charbel-j-estephan/CAN_IDS_IPS/esp32/replay_sender/replay_sender.ino

/* Sender: replays dataset frames onto the CAN bus with their original timing.
 *
 * The PC (python/replay_dataset.py) streams frames over USB serial, each with
 * the time it had in the original capture. This board waits until that moment
 * and then sends the frame, so the bus carries the same traffic pattern the
 * car did. Use a data cable: the PC needs this board's COM port.
 *
 * In the 3-board bench this board sends the normal traffic, and its first frame
 * is the start marker the attacker (attack_sender) starts its clock on.
 *
 * Serial protocol, 921600 baud, 8N1:
 *   board -> PC   "READY\n" once at boot
 *   PC -> board   15 byte packets: id_hi id_lo dlc d0..d7 t0 t1 t2 t3
 *                 t is a 32 bit little endian count of microseconds since the
 *                 first frame. t = 0 means "send now" (used for the fast mode).
 *   board -> PC   one byte 'A' after every ACK_EVERY frames sent
 *   PC -> board   'Q'  ->  "#TX sent=<n> late=<n> maxlate=<us> tec=<n> rec=<n>
 *                           state=<running|busoff|recovering|stopped>
 *                           arblost=<n> txfail=<n> buserr=<n>\n"
 *
 * "late" counts frames handed to the CAN controller more than 100 us after
 * their time. tec/rec are the controller's transmit/receive error counters,
 * arblost how often another node won arbitration (for example a DoS attacker
 * with ID 0x000), txfail frames that could not be sent.
 *
 * Wiring: module TX -> GPIO 5, module RX -> GPIO 4. See docs/ESP32_WIRING.md
 */
#include "driver/twai.h"
#include "esp_timer.h"

#define PIN_CAN_TX  GPIO_NUM_5
#define PIN_CAN_RX  GPIO_NUM_4
#define ACK_EVERY   64
#define PACKET_LEN  15

// Start marker for the attacker (same as attack_sender.ino): ID 0x7FF with
// "CANSTART", 224 us on the wire. When the first packet is the marker, time
// zero is taken from when the marker finished going out, minus its length:
// exactly how the attacker sets its time zero when it hears the marker. Taking
// it when the frame is handed to the controller instead made the attacker run
// about 77 us late.
#define MARKER_ID   0x7FF
#define MARKER_US   224
static const uint8_t MARKER_DATA[8] = {'C', 'A', 'N', 'S', 'T', 'A', 'R', 'T'};

// Final report. Lower case words only: the PC strips the 'A' ack bytes.
static void report(uint32_t sent, uint32_t late, uint32_t max_late)
{
    twai_status_info_t s = {};
    twai_get_status_info(&s);
    const char *state = s.state == TWAI_STATE_RUNNING ? "running"
                      : s.state == TWAI_STATE_BUS_OFF ? "busoff"
                      : s.state == TWAI_STATE_RECOVERING ? "recovering" : "stopped";
    Serial.printf("#TX sent=%lu late=%lu maxlate=%lu tec=%lu rec=%lu state=%s arblost=%lu txfail=%lu buserr=%lu\n",
                  (unsigned long)sent, (unsigned long)late, (unsigned long)max_late,
                  (unsigned long)s.tx_error_counter, (unsigned long)s.rx_error_counter, state,
                  (unsigned long)s.arb_lost_count, (unsigned long)s.tx_failed_count,
                  (unsigned long)s.bus_error_count);
}

void setup()
{
    Serial.setRxBufferSize(8192);
    Serial.begin(921600);

    twai_general_config_t g = TWAI_GENERAL_CONFIG_DEFAULT(PIN_CAN_TX, PIN_CAN_RX, TWAI_MODE_NORMAL);
    g.tx_queue_len = 16;
    g.alerts_enabled = TWAI_ALERT_TX_SUCCESS;    // to time the start marker
    twai_timing_config_t t = TWAI_TIMING_CONFIG_500KBITS();
    twai_filter_config_t f = TWAI_FILTER_CONFIG_ACCEPT_ALL();

    while (twai_driver_install(&g, &t, &f) != ESP_OK || twai_start() != ESP_OK) {
        Serial.println("CAN init failed. Retrying");
        twai_driver_uninstall();
        delay(500);
    }
    Serial.println("READY");
}

void loop()
{
    static uint8_t pkt[PACKET_LEN];
    static uint32_t sent = 0, late = 0, max_late = 0;
    static int64_t t0 = -1;

    if (Serial.peek() == 'Q' && Serial.available() < PACKET_LEN) {
        Serial.read();
        report(sent, late, max_late);
        return;
    }
    if (Serial.available() < PACKET_LEN)
        return;
    Serial.readBytes(pkt, PACKET_LEN);

    uint32_t rel = (uint32_t)pkt[11] | ((uint32_t)pkt[12] << 8) |
                   ((uint32_t)pkt[13] << 16) | ((uint32_t)pkt[14] << 24);
    uint32_t id = (((uint32_t)pkt[0] << 8) | pkt[1]) & 0x7FF;
    bool marker = t0 < 0 && id == MARKER_ID && pkt[2] == 8 && memcmp(&pkt[3], MARKER_DATA, 8) == 0;
    if (t0 < 0 && !marker)
        t0 = esp_timer_get_time();       // the first frame defines time zero

    if (rel && t0 >= 0) {
        int64_t due = t0 + (int64_t)rel;
        while (esp_timer_get_time() < due) {
        }
        int64_t over = esp_timer_get_time() - due;
        if (over > 100) {
            late++;
            if ((uint32_t)over > max_late)
                max_late = (uint32_t)over;
        }
    }

    twai_message_t m = {};
    m.identifier = (((uint32_t)pkt[0] << 8) | pkt[1]) & 0x7FF;
    m.data_length_code = pkt[2] > 8 ? 8 : pkt[2];
    memcpy(m.data, &pkt[3], m.data_length_code);

    // A timeout means the TX queue was full, the frame was not queued, so
    // retrying cannot duplicate it.
    while (twai_transmit(&m, pdMS_TO_TICKS(100)) == ESP_ERR_TIMEOUT) {
    }

    if (marker) {
        // Poll (no blocking wait) so the moment is caught within microseconds,
        // the same way the attacker polls for the marker it receives.
        uint32_t alerts = 0;
        int64_t give_up = esp_timer_get_time() + 100000;
        while (esp_timer_get_time() < give_up) {
            if (twai_read_alerts(&alerts, 0) == ESP_OK && (alerts & TWAI_ALERT_TX_SUCCESS))
                break;
        }
        t0 = esp_timer_get_time() - MARKER_US;
    }

    if (++sent % ACK_EVERY == 0)
        Serial.write('A');
}
