charbel-j-estephan/CAN_IDS_IPS/mcu/stm32_ids/src/can_ids_model_p8.h

    // !!! This file is generated using emlearn !!!

    #include <stdint.h>

// Where the model's code goes. By default these are ordinary functions. A
// firmware can define CAN_IDS_FN / CAN_IDS_PUBLIC before including this file
// to put them in a linker section, for example RAM (stm32_ids/src/classify.c).
#ifndef CAN_IDS_FN
#define CAN_IDS_FN static inline
#endif
#ifndef CAN_IDS_PUBLIC
#define CAN_IDS_PUBLIC
#endif

    

CAN_IDS_FN int32_t can_ids_tree_0(const float *features, int32_t features_length) {
          if (features[9] < 254.500000f) {
              if (features[0] < 0.500000f) {
                  if (features[7] < 0.500000f) {
                      if (features[5] < 99.500000f) {
                          return 1;
                      } else {
                          return 2;
                      }
                  } else {
                      return 2;
                  }
              } else {
                  if (features[6] < 66.500000f) {
                      if (features[3] < 191.500000f) {
                          if (features[0] < 1520.500000f) {
                              if (features[9] < 20.500000f) {
                                  if (features[6] < 38.500000f) {
                                      if (features[4] < 128.500000f) {
                                          if (features[6] < 18.500000f) {
                                              return 0;
                                          } else {
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
                      }
                  } else {
                      if (features[8] < 55.500000f) {
                          if (features[0] < 330.500000f) {
                              return 0;
                          } else {
                              return 2;
                          }
                      } else {
                          return 2;
                      }
                  }
              }
          }
        }
        

CAN_IDS_PUBLIC int32_t can_ids_predict(const float *features, int32_t features_length) {

        int32_t votes[5] = {0,};
        int32_t _class = -1;

        _class = can_ids_tree_0(features, features_length); votes[_class] += 1;
    _class = can_ids_tree_1(features, features_length); votes[_class] += 1;
    _class = can_ids_tree_2(features, features_length); votes[_class] += 1;
    _class = can_ids_tree_3(features, features_length); votes[_class] += 1;
    _class = can_ids_tree_4(features, features_length); votes[_class] += 1;
    
        int32_t most_voted_class = -1;
        int32_t most_voted_votes = 0;
        for (int32_t i=0; i<5; i++) {

            if (votes[i] > most_voted_votes) {
                most_voted_class = i;
                most_voted_votes = votes[i];
            }
        }
        return most_voted_class;
    }
    

int can_ids_predict_proba(const float *features, int32_t features_length, float *out, int out_length) {

        int32_t _class = -1;

        for (int i=0; i<out_length; i++) {
            out[i] = 0.0f;
        }

        _class = can_ids_tree_0(features, features_length); out[_class] += 1.0f;
    _class = can_ids_tree_1(features, features_length); out[_class] += 1.0f;
    _class = can_ids_tree_2(features, features_length); out[_class] += 1.0f;
    _class = can_ids_tree_3(features, features_length); out[_class] += 1.0f;
    _class = can_ids_tree_4(features, features_length); out[_class] += 1.0f;
    
        // compute mean
        for (int i=0; i<out_length; i++) {
            out[i] = out[i] / 5;
        }
        return 0;
    }
    
// Which model this is: shown by the firmware in READY and #STAT.
#define CAN_IDS_MODEL_ID "rf5-d9-p8-c0f7e8b5"
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
