charbel-j-estephan/CAN_IDS_IPS/(commit log)

2026-09-24 Add training, Verilog and C export pipeline for the CAN IDS
    Train a random forest on the HCRL Car Hacking Dataset and export it to a
    pipelined Verilog module for the DE10 Lite and to emlearn C for the
    STM32F407. Shared test vectors prove the FPGA logic, the C code and Python
    agree frame for frame.
    Replace skhdl_64 with a new exporter because it averages a class 0 value
    (regression, not classification), crashes on scikit learn 1.2+ and is tied
    to a Xilinx UART setup. Fix two emlearn mismatches with scikit learn
    (< versus <= and int16 threshold rounding) by moving thresholds to
    floor(t) + 0.5 and exporting floats.
    Also add the Quartus project for the 10M50DAF484C7G, an Icarus Verilog
    testben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
    [dataset.py, export_c.py, export_verilog.py, forest.py, ids_timing.c, ids_timing.h]
2026-09-24 Add literature review fixes and complete reference details
    Fill in the DOIs for [3], [7], [8] and [15] from the papers, and list
    drop in corrections for the review's factual errors plus the missing
    Abbott-McCune and Shay FPGA plus MCU prototype.
2026-09-24 Use Charbel's own LaTeX source for the literature review
    Replace the rebuilt file with the author's source and apply the fixes it
    did not have yet: the tools paragraph, the Abbott-McCune and Shay FPGA
    plus MCU prototype (text, table row and gap sentence), and the fuller
    reference [8]. Layout and reference formatting are unchanged.
2026-10-04 Add two ESP32 + MCP2515 CAN test bench: sender, receiver, scorer, wiring guide
2026-10-04 Add PlatformIO blink test for the STM32F407VET6 board
2026-10-04 Add STM32 CAN gateway, ESP32 pass-through receiver and gateway scoring
2026-10-05 Fix frame timing: 8 byte frame is about 220 us at 500 kbit/s, drop the 150 us gap
2026-10-05 Replay: survive WiFi drops, ignore stale buffered frames, match by time
    wifi_receiver now finishes partial TCP writes instead of dropping the link.
    replay_dataset accepts reconnects, discards frames buffered before the run,
    drops resent duplicates, and matches identical frames by expected time.
2026-10-05 Replay: start each frame one exact frame length before its end timestamp
    The Car Hacking dataset stamps frames when they end. Starting a frame at that
    time made short frames (0x5F0, 2 bytes) arrive about 100 us early whenever the
    bus was idle before them. can_bits computes the exact on-wire length including
    stuff bits so each frame ends at its original time.
2026-10-05 Add usb_receiver and --receiver: record the replay over USB instead of WiFi
    The phone hotspot lost 30% of packets, so WiFi could not carry the frames.
2026-10-05 Add STM32 forwarding gateway (CAN1 to CAN2, no filtering) and --gateway analysis
    The analysis removes the unavoidable one-frame store-and-forward delay and
    reports the gateway's own added delay; the gateway's counters are read over
    its USB port.
2026-10-12 Add run_check.py: find the boards, check the link, replay, open the report
2026-10-12 Clean up the CAN bench: keep only the working USB replay
    Removed the MCP2515, WiFi, IDS-on-ESP32 and STM32 gateway variants and the
    WiFi/gateway code paths. open_board/stream move to serial_link.py. Added
    sync_bench.py to copy the bench to the run folder, and rewrote the wiring and
    handover docs for the bench as it is.
2026-10-12 Add the attacker node: attack frames from a third ESP32
    attack_sender starts its clock from a start marker the normal sender puts on
    the bus, so both boards share one time base. replay_dataset --attacker splits
    the frames by label and streams both senders in parallel; each sender reports
    its error counters, bus state and lost arbitrations; the results page shows a
    per-board table and how closely the attacker synced. run_check finds the
    attacker by its READY ATTACKER line.
2026-10-12 run_check: say which sketch to upload when two boards run the same one
2026-10-12 replay_sender: take time zero from when the start marker finished sending
    It was taken when the marker was handed to the controller, about 77 us before
    it went out, so the attacker (which syncs on hearing the marker) ran 77 us late
    and its frames pushed the normal frames aside in arbitration.
2026-10-12 attack_sender: follow the normal sender's clock for the whole run
    The marker lines both boards up at the start, but C's crystal ran 6.4 ppm off
    A's, so attack frames fell about 6 us per second behind (80 us after 14 s)
    and dragged the normal frames queued behind them (normal median 26 us).
    The PC now also sends C a timing reference for every normal frame (when it
    should end on the bus). C pairs them with the frames it hears, takes the
    earliest arrival in each 250 ms window and shifts its schedule by how far
    that has moved since the start, plus the drift measured so far.
2026-10-12 Measure the attacker offset on clear-bus frames and trim it out
    The old offset was the gap between two straight-line fits, and the normal
    fit was pulled by the frames the attacker pushed aside, so it read 9.6 us
    while the attacker was really 35 us late. It is now the median gap, against
    A's clock, between attack and normal frames that had the bus idle for 100 us
    before them in the capture (2-board check: within 2 us of 0).
    attack_sender takes time zero 35 us earlier (SYNC_TRIM_US): it stamps the
    marker when it has received it, A when its controller reports it sent, and
    the two latencies differ.
2026-10-12 attack_sender: raise the sync trim to 43 us
    With 35 us the attacker still sent about 8 us late (run 20261012_230423,
    clear-bus frames, and frame by frame against the 2-board run).
2026-10-12 replay_dataset: pair identical frames from one board in order
    Matching by nearest time could pair two identical frames crosswise when one
    was late (DoS 0x000 frames 0.33 ms apart): +322 / -158 us instead of about
    +190 / +4. One node sends identical frames in order, so after matching each
    board's identical frames are paired in arrival order. Rescored runs: only
    the worst case changes (322 -> 178 us, and 317 -> 181 us in 20261005_123401).
2026-10-12 Add the STM32 IDS node wiring guide
2026-10-12 Name the bench boards sender, attacker and receiver
    No more ESP32 A / B / C in the sketches, scripts, script output, results
    page node names and docs. The STM32 wiring guide is now for a TJA1050
    module: 5 V supply, RX straight to PB8 (5 V tolerant), PB9 open drain so
    the module's own pull up holds it recessive.
2026-10-13 STM32 M1: receive CAN frames in software on PB8
    mcu/stm32_ids, a PlatformIO project for the black F407VE with a TJA1050.
    TIM4 captures every falling edge on PB8 in hardware (hard sync on the start
    of frame, resync on every other edge) and interrupts at the sample point of
    each bit, half a bit after the edge. can_rx.c, plain C, destuffs, checks the
    CRC-15 and the form bits and hands good frames to loop(), which sends them
    to the PC in the receiver's 16 byte record with a TIM2 microsecond stamp.
    PB9 stays open drain and released, so the STM32 never touches the bus.
    run_check.py --stm32 (run_check_stm32.bat) checks the frames the STM32
    decodes; the ESP32 receiver stays on the bus to ACK. The d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
2026-10-13 stm32_ids: glitch free TX at boot, SysTick below the bit interrupt
    PB9 is set high before it becomes an output, so booting never puts a
    dominant bit on the bus. SysTick moves to priority 1 (USB is already 1), so
    nothing at the bit interrupt's priority can delay a sample. The wiring guide
    tests the STM32's wiring with the ESP32 receiver first, and the handover
    says what was really tested: a Python copy of the decoder, not the C.
2026-10-13 Receiver may be the STM32: take its #STAT line as ready
    Windows does not pass an RTS change on to the STM32's USB serial port, so
    it never answered the scripts' restart pulse with READY and open_board
    waited 20 s and gave up. The receiver now counts as ready on READY or on
    the #STAT line it prints every second. Checked on the board (COM11).
2026-10-13 stm32_ids: take the start bit from its edge, run the bit interrupt from RAM
    First bus test: 300 of 300 frames while the PC was not reading the STM32,
    247 of 300 while it was. Only IDs 0x400 and up were lost, the frames whose
    start bit is followed by a recessive bit. The start bit was sampled 0.5 bit
    after its edge by the first interrupt after an idle bus; with USB busy that
    interrupt ran from a cold flash cache and came more than 1 us late, read the
    next bit, and the frame was lost (stuff and CRC errors on its remains).
    The start bit is dominant by definition, so it is now passed as 0 and the
    first sample is the next bit, 1.5 bits after the edge. The interrupt and the
    decoder also run from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
2026-10-13 stm32_ids fw 3: one interrupt per bit, timing counters, upload over USB
    The build that ran the bit interrupt from RAM decoded 0 of 300 frames
    (247 of 300 from flash before). Code fetched from SRAM shares one bus with
    the decoder's data and the peripherals, so RAM is now opt in
    (-D CAN_RX_IN_RAM) and the code is back in flash.
    The edge interrupt is now only on while the bus is idle (start of frame);
    inside a frame the sample interrupt reads the captured edge time to resync,
    so one interrupt per bit instead of two. #STAT adds isr (longest interrupt,
    CPU cycles), lat (latest sample, TIM4 ticks), nlate (samples > 63 ticks
    late) and fw, and READY carries fw too.
    "DFU!" over USB restarts the STM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
2026-10-13 stm32_ids fw 4: own vector table, so it runs right after a DFU upload
    fw 3 passed on the bench: 3-board DoS replay with the STM32 as the receiver,
    20,000 of 20,000, no new decoding errors, longest bit interrupt 417 cycles,
    latest sample 50 TIM4 ticks (limit 84).
    After an upload dfu-util starts the program straight from the bootloader,
    which leaves VTOR pointing at the bootloader's vectors: the USB serial port
    enumerated but every request failed until a reset. A constructor now sets
    VTOR to this program's table before anything else runs.
2026-10-13 Revert "stm32_ids fw 4: own vector table, so it runs right after a DFU upload"
    This reverts commit b2cb796f9d3ea9204a583f86cd7f9b515e7f074d.
2026-10-13 Drop the USB restart into the bootloader, record M1 as working
    fw 4's vector table fix did nothing (the core's SystemInit already sets
    VTOR), so it was reverted. Asking fw 3 to restart into the bootloader over
    USB made the board drop off USB without the bootloader appearing, so
    stm32_dfu.py and upload_stm32.bat are removed (and from the bench copy);
    the firmware's jump code stays, marked as not working, so the source still
    matches the fw 3 on the board. Uploads use the BOOT0 jumper, then RST.
2026-10-13 train.py: time split by default, per class counts and confusion matrix
    The random split scored the model on frames often identical to training
    frames. --split time (default) cuts every file at one moment and tests on
    what came after. The attacks fill only the first ~80% of each recording, so
    an attack file is cut where 20% of its attack frames remain (cutting at 80%
    of the frames left 0 DoS, Fuzzy and Gear frames to test on).
    Report settings (5 trees, depth 9, ID + DLC + 5 bytes): 6.54 M test frames,
    accuracy 0.99916; DoS, Gear and RPM recall 100%, Fuzzy 95.2%.
    dataset.load(with_source=True) says which file each frame came from.
    requirements.txt adds setuptools (emlearn needs distutils on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
2026-10-13 Unknown ID rule: Fuzzy recall 95.2% -> 99.9%
    98% of the Fuzzy frames the forest missed carry an ID the car never sends.
    The normal traffic uses 38 of 2048 IDs, and 9 comparisons per tree cannot
    single those out, so a Normal verdict on an ID absent from the normal
    training traffic now becomes Fuzzy (forest.known_id_rule). Other verdicts
    stay, so DoS (0x000) keeps its class.
    5 trees, depth 9, ID + DLC + 5 bytes, time split: Fuzzy recall 95.18% ->
    99.91%, attack frames flagged 98.982% -> 99.980%, false alarms unchanged
    (720 of 6.07 M). train.py reports the forest alone and with the rule and
    saves known_ids; export_c.py writes them as a 2048 bit table with
    can_ids_id_known(), checked against th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
2026-10-13 STM32 M2: classify every frame on the STM32, score it on the PC
    fw 5. When the ID, DLC and first 5 data bytes are in (can_rx returns
    CAN_RX_FEATURES), the bit interrupt copies them and pends TIM7's vector,
    which runs the forest plus the unknown ID rule (classify.c, model exported
    by export_c.py into can_ids_model.h) while the frame is still arriving.
    Priorities: bit timing 0, model 1, USB and SysTick 2. Records become 0xA8,
    23 bytes: the frame, its class (0xFF no decision by the 6th end of frame
    bit, 0xFE model off) and TIM4 ticks from the start of frame edge to the
    features, the decision and the frame end. 'C'/'c' switch the model on/off
    to A/B the bit timing; #STAT adds model, cmax, dlate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
2026-10-29 stm32_ids fw 6: run the model from RAM
    fw 5 on hardware: the bit interrupt sampled up to 120 TIM4 ticks late (limit
    84) and 296 of 300 frames failed CRC or stuffing. The forest ran from flash,
    and its code is much bigger than the 1 KB flash cache, so each bit interrupt
    that cut into it found its own code evicted. The model (can_ids_predict and
    classify) now runs from RAM; the bit interrupt stays in flash, where fw 3
    decoded 19,999 of 20,000 (moving it to RAM made fw 2 worse). export_c.py
    marks the model functions with CAN_IDS_FN / CAN_IDS_PUBLIC so a firmware can
    place them; the defaults keep other users unchanged.
2026-10-29 stm32_ids fw 7: lighter bit interrupt, diagnostic switches
    fw 6 failed with the model switched off too, and fw 3 decodes perfectly on the
    same bus, so fw 5/6 broke the bit timing itself. In the compiled code fw 5
    had keep() and features_in() inlined into the bit interrupt, which then saved
    9 registers on every bit (fw 3: 5); can_rx_bit grew from 244 to 279
    instructions. Both helpers are now noinline (entry back to 5 registers).
    Diagnostics over USB: Z zero counters, f/F mid-frame features off/on,
    p/P fw 3 / fw 5 priorities; #STAT adds the average bit interrupt length and a
    count of interrupts over 300 cycles. The model is back in flash (RAM is now
    -D MODEL_IN_RAM): fw 6's move did not help.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
2026-11-01 stm32_ids fw 8: prevention (M3), and the IPS test on the PC
    When the model calls a frame an attack, the STM32 sends an active error flag:
    PB9 dominant for 6 bit times from the next bit boundary, driven by TIM4
    channel 4 output compare so it starts and ends on the exact tick. Too late
    (end of frame field already begun): the frame stands, counted as ilate. The
    replay's start marker is allow listed. Off at power up, I/i over USB, never
    more than 8 bits dominant. #STAT adds ips, rej, ilate, allow, abort.
    replay_dataset.py --ips COMx switches prevention on for the replay only (off
    again however the script ends) and reports attack frames destroyed and normal
    frames lost from the ESP32 receiver's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
2026-11-01 stm32_ids fw 9 test: fw 3's per bit work (IDS_HOT=0)
    fw 8 decoded 0 of 20,000 frames even with the model, the features step and
    the new priorities switched off at run time (avg 255 cycles per bit). fw 9
    puts everything fw 5..8 added to the bit interrupt behind IDS_HOT, off in
    this build, to tell per bit cost apart from a setup or layout cause.
2026-11-01 stm32_ids fw 10: lighter bit interrupt with the model and prevention back
    fw 9 (fw 3's per bit work) decoded 19,991 of 20,000 but sampled up to 88
    ticks late against an 84 tick margin: fw 3 never had room to spare. fw 10
    samples a quarter bit after the edge (126 ticks of margin), reduces M3 to one
    byte test per bit, and drops the fw 7 average and slow counters.
2026-11-01 stm32_ids fw 11: model from RAM by default
    fw 10 (lighter bit interrupt) still sampled up to 130 ticks late with the
    model running, against 88 for fw 9 without it: the model in flash evicts the
    bit interrupt from the flash cache. The model now runs from SRAM.
2026-11-01 stm32_ids fw 12: fewer timer reads in the bit interrupt
    fw 11 decided every frame only 0.08-0.24 us before its end: the bit
    interrupt leaves the model almost no CPU inside a frame. TIM4 sits on APB1,
    so each register read costs several cycles. The bit interrupt now reads SR
    and CNT once per bit (CCR3 on edges); the sample time and interrupt enables
    come from RAM, and can_rx_bit reports the return to idle itself.
2026-11-01 Record STM32 fw 12 as working: 20,000 of 20,000, DoS recall 100%
2026-11-01 Record the first IPS run: 99.91% of DoS frames stopped, 0 normal lost
2026-11-01 stm32_ids fw 13: catch the resend after an error frame
    The first IPS run let 5 DoS frames through, all resends right after an error
    frame that the STM32 did not decode. After an error the decoder now takes the
    bus as idle after the 8 bit error delimiter instead of 11 bits, and the error
    flag code runs from RAM instead of cold flash.
2026-11-01 stm32_ids fw 14: flags that always fire, no deaf decoder; leak report on the PC
    fw 13 let 16 DoS frames through (fw 12: 5) with samples up to 819 ticks late
    around the flags. The flag code is back in flash, its start compare is set
    from a fresh counter read and its steps follow the CC4 match flag, so a late
    interrupt can no longer schedule a flag that never happens. sample_at checks
    the counter again when the next sample is close, so a late interrupt can no
    longer leave the decoder deaf for a counter wrap. IPS runs now keep the
    STM32's own records and say, for each attack frame that got through, whether
    the STM32 heard it and what it decided (leaks.csv).
2026-11-01 Record fw 14 IPS runs: DoS, Fuzzy, gear stopped; RPM fails
2026-11-01 stm32_ids fw 15: flag diagnostics for the RPM failure
    Without prevention RPM is clean (0 bus errors, 100% recall, 0 false alarms),
    but with prevention almost every flag was cut by the safety limit. fw 15
    counts start and end matches, moved and given up starts and catch-up
    samples, and snapshots the timer state at the first cut, in a #DBG line
    that replay_dataset prints and saves.
2026-11-01 stm32_ids fw 16: check the flag start compare after it is set
    fw 15's diagnostics showed the RPM flags that were cut: the start compare
    was 21 ticks ahead when the counter was read, and the counter passed it
    before the write reached the timer, so it never matched. The lead is now 40
    ticks, and after the write the counter is read again; a missed start moves
    to the next bit.
2026-11-01 Record fw 16 RPM IPS run: 4,075 of 4,075 stopped, 3 normal frames lost
2026-11-01 Record fw 16 on all four attacks: every attack frame stopped
2026-11-01 FPGA CAN receiver and 5 / 6 / 8 byte models on the FPGA and the STM32
    FPGA (Verilog, simulated in Icarus):
    - hdl/can_rx.v: bit timing with resync on every falling edge, destuffing,
    CRC-15, form checks; FEAT_BYTES sets after how many data bytes the
    features are ready. Passes can_rx_tb.v at 0 and +-3000 ppm.
    - hdl/known_id.v: the unknown ID rule's 38 IDs, checked on all 2048 IDs
    against the model (known_id_tb.v).
    - hdl/frames_tb.v + python/make_sim_frames.py + python/compare_sim.py:
    real dataset frames bit by bit through can_rx, the forest and the ID rule,
    compared with Python frame by frame (run_sim.bat 5 / 6 / 8).
    - hdl/rf_all_tb.v + python/fpga_accuracy.py: every distinct frame of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
2026-11-01 IPS error flag on the FPGA, tested on a simulated CAN bus
    hdl/ips_flag.v: the FPGA version of M3 in stm32_ids main.cpp. An attack
    verdict (final class != Normal) starts a 6-bit dominant error flag at the
    next bit boundary, only while the frame can still be destroyed (before_eof),
    never on the allow-listed start marker (0x7FF "CANST"), never dominant for
    more than 8 bits (safety cut), off when prevention is off. Counts rej, ilate,
    allow and abort like the STM32. hdl/ips_flag_tb.v tests every rule.
    hdl/frames_tb.v -DWITH_IPS: the bus is wired-AND (dominant wins), can_rx and
    the IPS sit on it, and a second can_rx plays the ESP32 receiver.
    compare_sim.py checks frame by frame that every frame c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
2026-11-01 DE10-Lite board design: top level, Quartus project, board-level test
    quartus_board/: the project from Terasic System Builder (CLOCK, KEY, LED,
    SW, GPIO Default) plus the CAN IDS/IPS sources. can_ids_top.v connects
    GPIO[0] (CAN RX) -> can_rx -> rf_ids (6-byte model) + known_id -> ips_flag
    -> GPIO[1] (CAN TX, 1 = released). KEY[0] resets, SW[0] turns prevention on,
    LEDR0-3 show frames, attack verdicts, flags and bus errors for 100 ms each,
    LEDR9 shows prevention on.
    Quartus Prime Lite 25.1: 0 errors, 1 930 LEs (4 %), 362 registers,
    Fmax 81.8 MHz at slow 85 C for the 50 MHz clock.
    hdl/top_tb.v drives the design only through its pins on a wired-AND bus
    with a second receiver: 1000 real frames,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
2026-11-02 Mixed runs: all four dataset files in one replay, from held out frames
    --file mixed plays blocks of consecutive frames from every dataset file, in
    random order, each with its own timing, from the part of each file the model
    was not trained on (train.py --split time). The seed and the block plan are
    saved, so a run can be repeated and reanalysed. run_check_stm32_IDS.bat uses
    it by default; the link check stays on one file.
2026-11-02 GUI for the bench: board status, STM32 upload, FPGA sim/compile/program, tests
    run_GUI.bat opens python/bench_gui.py. It runs the existing scripts and tools
    and streams their output; the STM32 upload walks through the BOOT0 jumper
    steps and waits for the bootloader and the firmware to appear on USB.
2026-11-02 FPGA test day: perfboard pin test design, 2 hour checklist, GUI pin test button
    quartus_pintest/ shows the RX level, activity and 500 kbit/s on LEDs and
    drives TX from SW1 for a transceiver echo test. The ESP32 run prints a
    per class table (how an FPGA IPS is measured). make_sim_frames falls back
    to the bench dataset; the GUI warns when the .sof is older than the design.
2026-11-03 FPGA on the bench: IPS stops all four attacks, 8-byte board design, wiring notes
    DoS 1,861/1,861, Fuzzy 709/709, Gear 922/922, RPM 1,085/1,085 destroyed,
    attacker bus off each time; 2 of 3,915 normal frames lost in RPM, most
    likely by the ESP32 receiver (the attacker heard both). RX now reaches
    the FPGA through a 5 k / 5 k divider; the TXS0108E did not pass it.
    The board design is set to the 8-byte model that was tested.
2026-11-03 FPGA 6-byte model on the bench: all four attacks stopped; board design set to 6 bytes
    DoS 1,861/1,861 (two runs), Fuzzy 709/709, Gear 922/922, RPM 1,085/1,085;
    1 of 3,915 normal frames lost in RPM, during the error storm.
2026-11-03 FPGA 5-byte model on the bench: all four attacks stopped, 0 normal frames lost; board design set to 5 bytes
2026-11-03 --listen: the STM32 records next to the ESP32 receiver, prevention off
    For every normal frame the receiver lost, count identical copies sent,
    recorded by the receiver and by the STM32: shows whether the frame was on
    the bus (the receiver missed it) or never made it. To settle the RPM
    normal frames lost during the FPGA IPS error storm.
